hermonochy/The-Solar-Trapper/silverCrestReport/figures/curtainCircuit.pdf

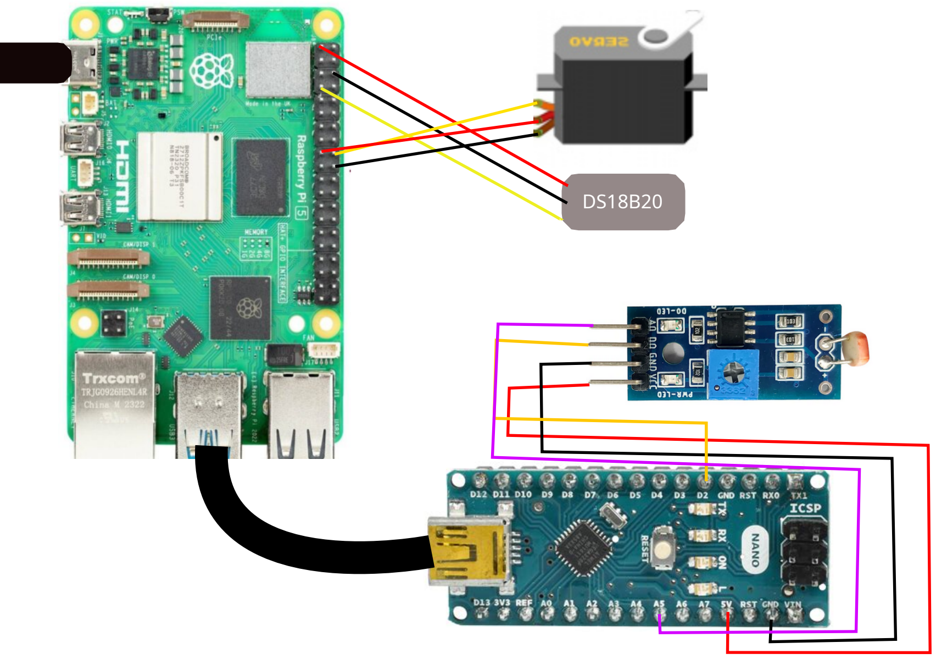
[picture p23: page 1]

DS18B20
