hermonochy/The-Solar-Trapper/data/250303.png

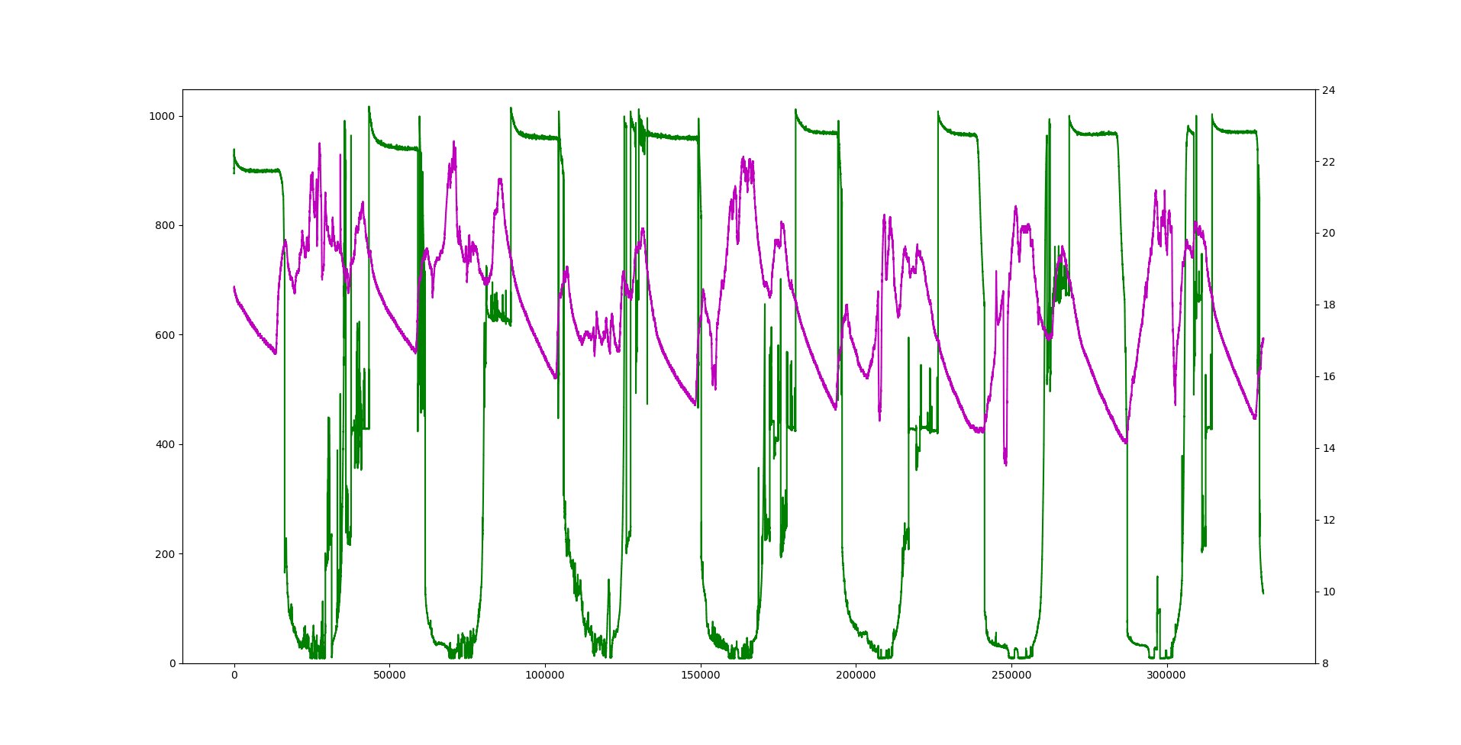
data/250303.png
