hermonochy/The-Solar-Trapper/data/HTMSolarTrappers.png

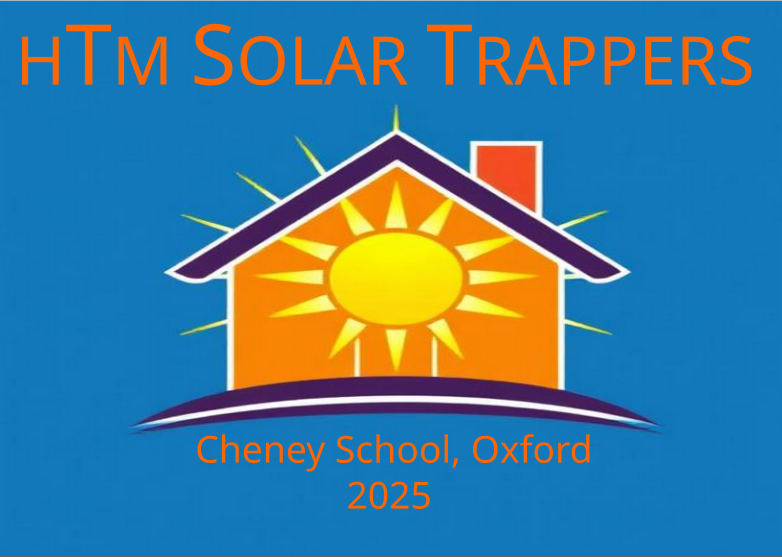
data/HTMSolarTrappers.png
