hermonochy/The-Solar-Trapper/data/SolarTrap.png

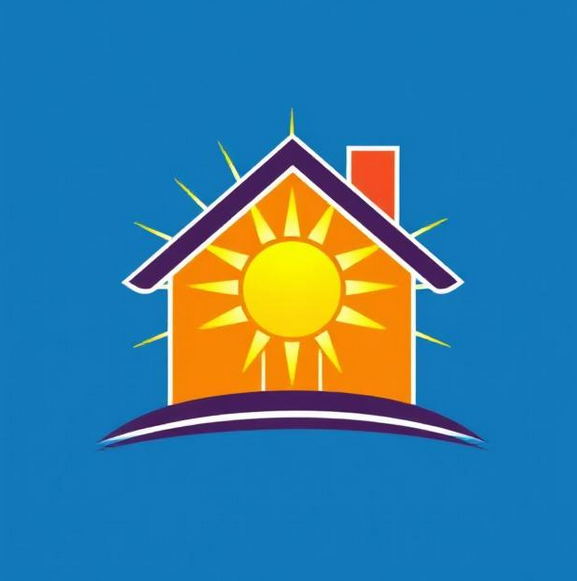
data/SolarTrap.png
