hermonochy/The-Solar-Trapper/silverCrestReport/figures/logDataPlot.png

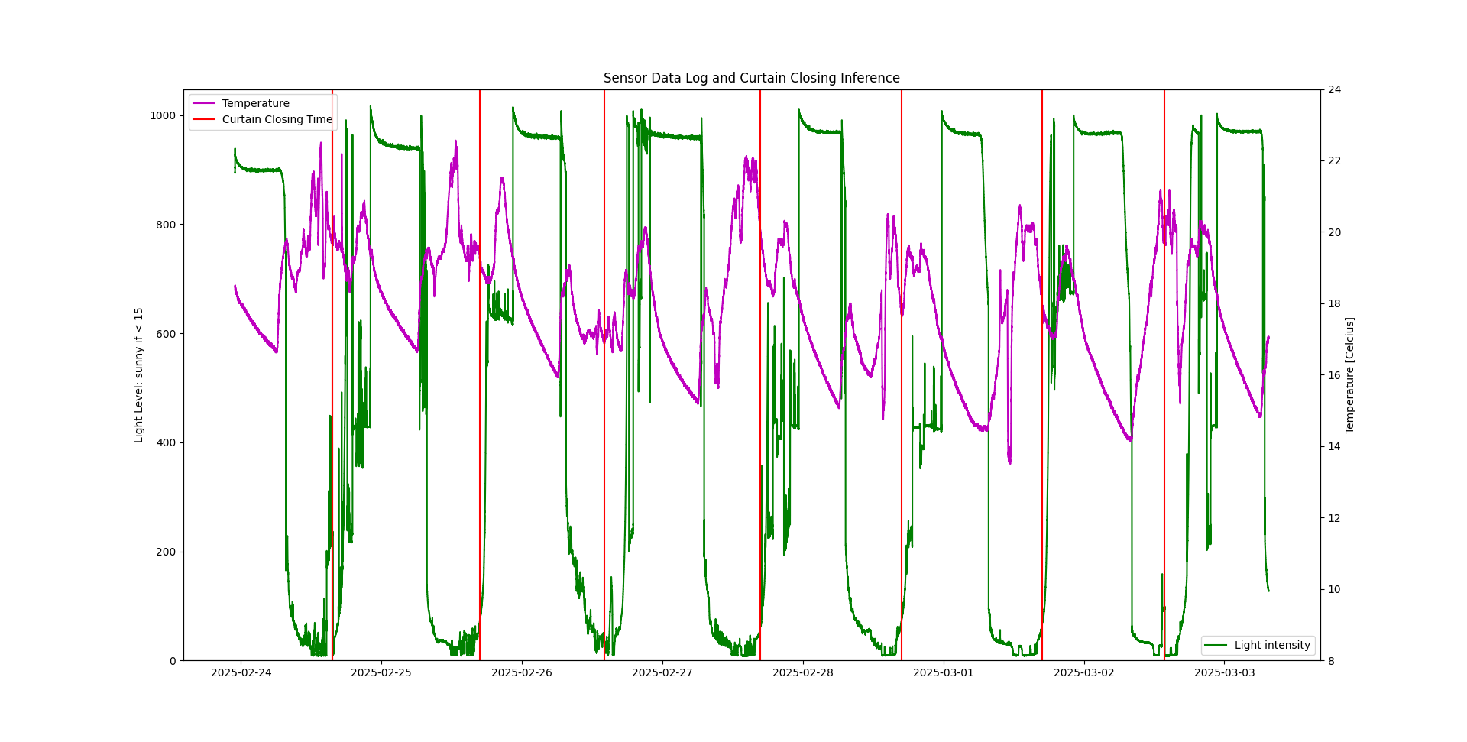
silverCrestReport/figures/logDataPlot.png
