hermonochy/The-Solar-Trapper/silverCrestReport/figures/Nano.png

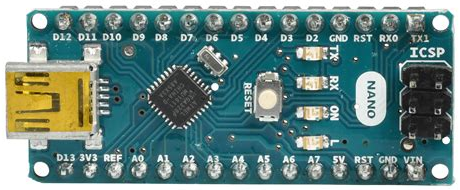
silverCrestReport/figures/Nano.png
