hermonochy/The-Solar-Trapper/silverCrestReport/figures/RasPi.png

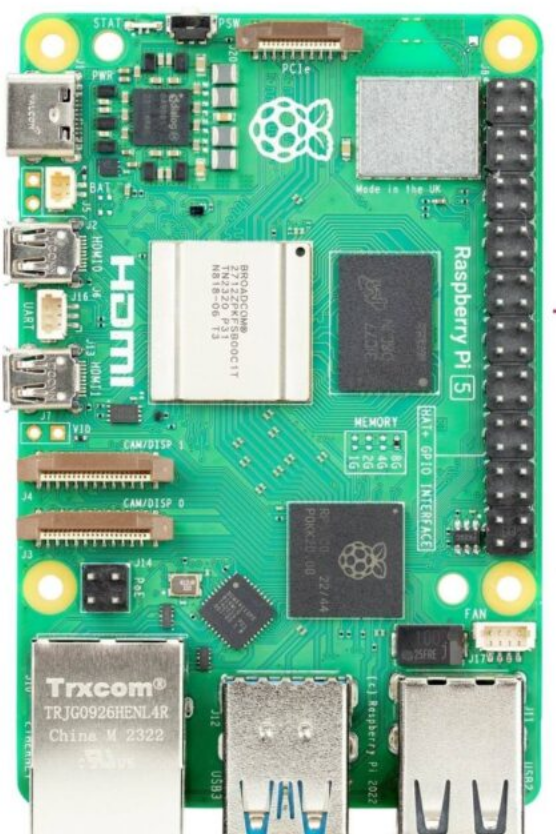
silverCrestReport/figures/RasPi.png
