hermonochy/The-Solar-Trapper/silverCrestReport/figures/gantt.pdf

2025
1 | 2 | 3 | 4 | 5 | 6

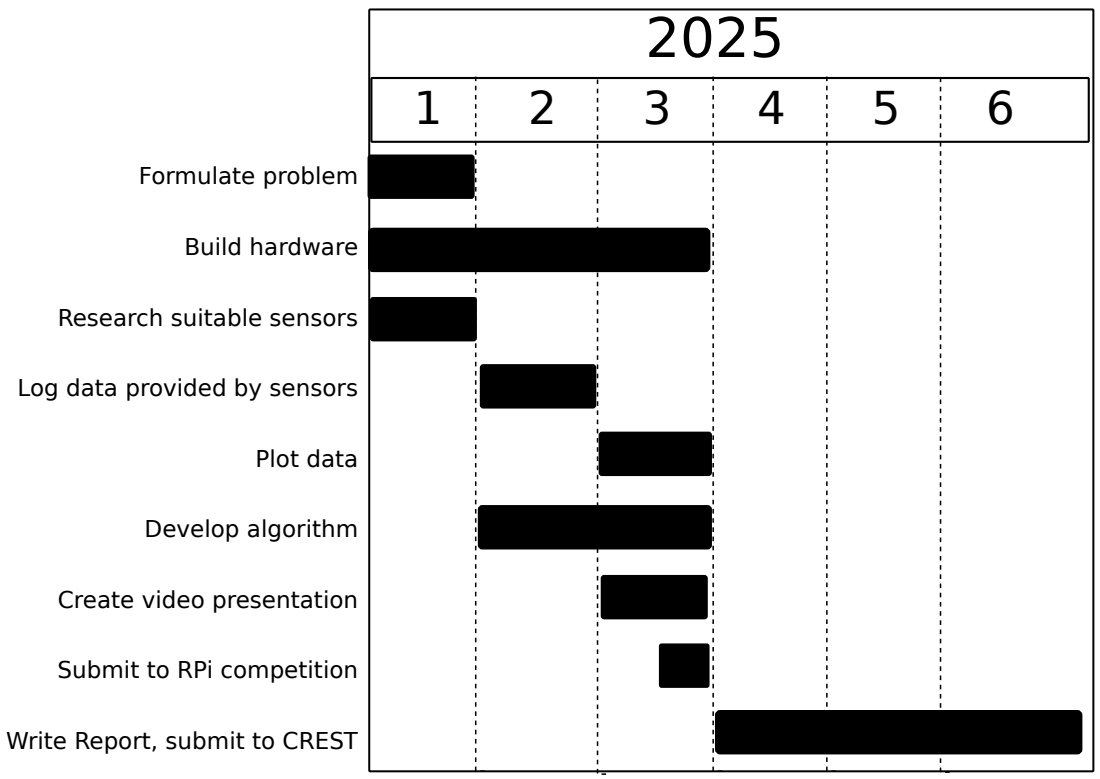
[picture p30: page 1]
Formulate problem; Build hardware; Plot data; Develop algorithm

Research suitable sensors

Log data provided by sensors

Create video presentation

Submit to RPi competition

Write Report, submit to CREST
