hermonochy/The-Solar-Trapper/(commit log)

2025-02-13 add sensors bought
2025-02-16 Light Sensor Test
2025-02-23 add data and plot code
    [20240216_bodyPeak.csv, 20240216_evening.csv, 20240216_overnight24h.csv, 2025-02-16.csv, 20250217_48h.csv]
2025-03-04 update plots and readme
    [20250217_48h.csv]
